zhongyi33/2021-Fall-ECE-411-Team-10/Photos/2.jpg

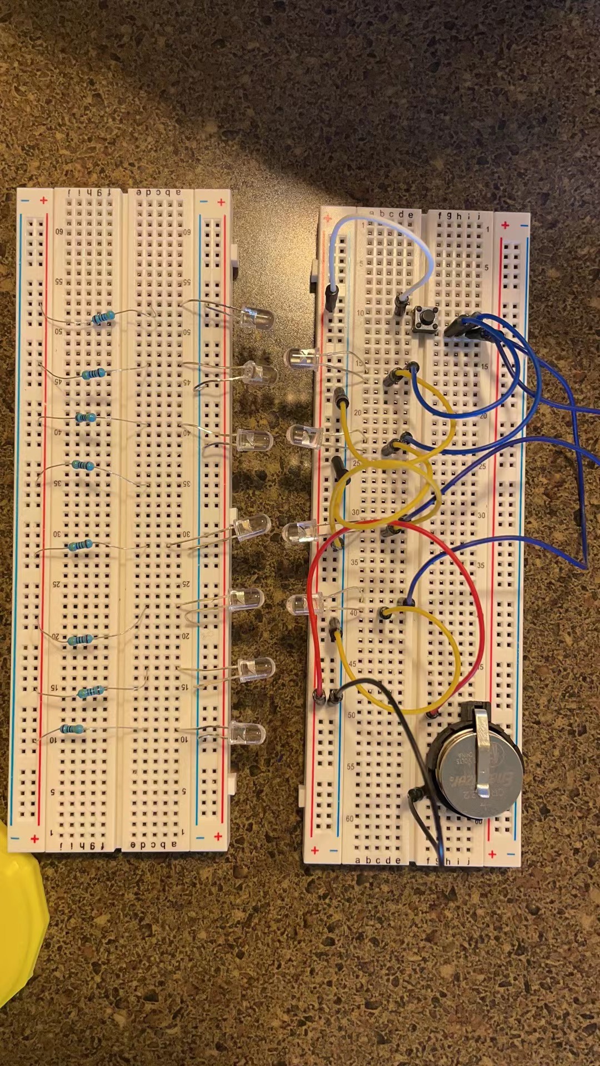
Photos/2.jpg
