zhongyi33/2021-Fall-ECE-411-Team-10/Photos/1.jpg

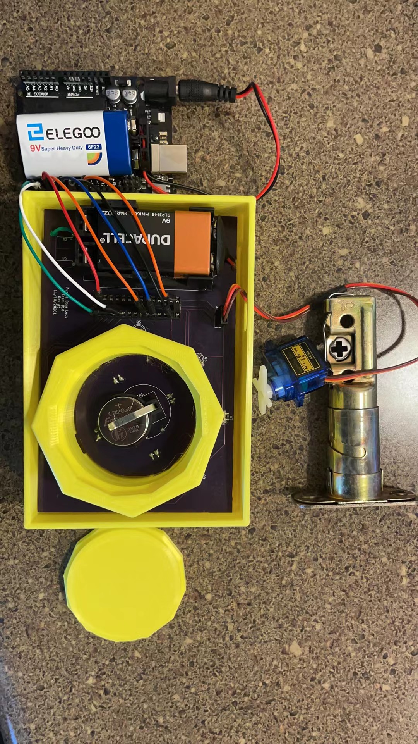
Photos/1.jpg
