zhongyi33/2021-Fall-ECE-411-Team-10/README.md

# 2021-Fall-ECE-411-Team-10

Group member: Bradley Huntington, Lihong Zhao, Tianshu Chu, Zhongyi Xu
