zhongyi33/2021-Fall-ECE-411-Team-10/ECE411 Team10 Final  Version of Project Schedule.pdf

2021 Fall ECE411 Team10 Puzzle lock | Nov 4, 2021
ECE411 team10 | http://
Project manager | Zhongyi Xu, Tianshu Chu, Lihong Zhao, Bradley Huntington
Project dates | Oct 7, 2021 - Dec 1, 2021
Completion | 44%
Tasks | 28
Resources | 4

Name | Begin date | End date | Coordinator
Develop Product Design Specifications | 10/7/21 | 10/20/21 | Bradley Huntington, Lihong Zhao, Tianshu Chu, Zhongyi Xu
Doucmentation: Brief Market analysis | 10/12/21 | 10/14/21 | Zhongyi Xu
System Architecture | 10/12/21 | 10/20/21 | Lihong Zhao
Choose Sensor/Controller/Firmware | 10/12/21 | 10/20/21 | Bradley Huntington
Choosing IDE | 10/12/21 | 10/20/21 | Tianshu Chu
Determining Appearance/Material /Shape of the lock | 10/12/21 | 10/15/21 | Lihong Zhao, Bradley Huntington
Start Github/Trello Organization | 10/7/21 | 10/13/21 | Zhongyi Xu, Tianshu Chu, Lihong Zhao
Schematic | 10/21/21 | 11/12/21 | Bradley Huntington
Preliminary Schematic Designing | 10/21/21 | 10/28/21 | Bradley Huntington
Update Schematic | 10/28/21 | 11/4/21 | Bradley Huntington
Final Schematic | 11/4/21 | 11/12/21 | Bradley Huntington
PCB | 10/28/21 | 11/19/21 | Bradley Huntington
First Draft | 10/28/21 | 11/4/21 | Bradley Huntington
Modifying Draft | 11/4/21 | 11/12/21 | Bradley Huntington
Generating Final Draft | 11/12/21 | 11/19/21 | Bradley Huntington
Block diagram | 10/21/21 | 11/26/21 | Lihong Zhao
Level 1 Block Diagram | 10/21/21 | 10/28/21 | Lihong Zhao
Level 0 Block Diagram | 11/4/21 | 11/15/21 | Lihong Zhao
Final Checking to Level 0&1 Block Diagram | 11/18/21 | 11/26/21 | Lihong Zhao
Bill of Materials | 11/4/21 | 11/26/21 | Zhongyi Xu
First Version | 11/4/21 | 11/12/21 | Zhongyi Xu
Final Version | 11/18/21 | 11/26/21 | Zhongyi Xu
2021 Fall ECE411 Team10 Puzzle lock | Nov 4, 2021
Tasks | 2

Name | Begin date | End date | Coordinator
3D Module | 11/12/21 | 11/26/21 | Tianshu Chu, Lihong Zhao, Bradley Huntington
Designing | 11/12/21 | 11/18/21 | Tianshu Chu
Printing 3D Module | 11/18/21 | 11/26/21 | Lihong Zhao, Bradley Huntington
Final Assembiy/Testing | 11/22/21 | 11/30/21 | Zhongyi Xu, Tianshu Chu, Lihong Zhao, Bradley Huntington
Testing | 11/22/21 | 11/22/21 | Lihong Zhao, Bradley Huntington
Debug | 11/22/21 | 11/30/21 | Tianshu Chu, Lihong Zhao
Tasks | 3

Name | Default role
Zhongyi Xu | project manager
Tianshu Chu | project manager
Lihong Zhao | project manager
Bradley Huntington | project manager

## Resources

4

## Gantt Chart

5

Name | Begin da... | End date | Coordinator
Develop Product ... 10/7/21 | 10/20/21 Bradley Huntingto...

Doucmentatio... 10/12/... 10/14/21 Zhongyi Xu

System Archit... 10/12/... 10/20/21 Lihong Zhao

Choose Senso... 10/12/... 10/20/21 Bradley Huntington

Choosing IDE 10/12/... 10/20/21 Tianshu Chu

Determining A... 10/12/... 10/15/21 Lihong Zhao, Bradl...

Start Github/T... 10/7/21 | 10/13/21 Zhongyi Xu, Tiansh...
Schematic | 10/21/... 11/12/21 Bradley Huntington

Preliminary Sc... 10/21/... 10/28/21 Bradley Huntington

Update Sche... 10/28/... 11/4/21 | Bradley Huntington
Final Schematic 11/4/21 | 11/12/21 Bradley Huntington
PCB | 10/28/... 11/19/21 Bradley Huntington
First Draft | 10/28/... 11/4/21 | Bradley Huntington
Modifying Draft 11/4/21 | 11/12/21 Bradley Huntington

Generating Fi... 11/12/... 11/19/21 Bradley Huntington

Block diagram 10/21/... 11/26/21 Lihong Zhao

Level 1 Block ... 10/21/... 10/28/21 Lihong Zhao

Level 0 Block ... 11/4/21 11/15/21 Lihong Zhao

Final Checking... 11/18/... 11/26/21 Lihong Zhao

Bill of Materials | 11/4/21 | 11/26/21 Zhongyi Xu
First Version | 11/4/21 | 11/12/21 Zhongyi Xu
Final Version | 11/18/... 11/26/21 Zhongyi Xu
3D Module | 11/12/... 11/26/21 Tianshu Chu, Lihon...
Designing | 11/12/... 11/18/21 Tianshu Chu

Printing 3D M... 11/18/... 11/26/21 Lihong Zhao, Bradl...

Final Assembiy/T... 11/22/... 11/30/21 Zhongyi Xu, Tiansh...

Testing | 11/22/... 11/22/21 Lihong Zhao, Bradl...
Debug | 11/22/... 11/30/21 Tianshu Chu, Lihon...
November 2021 | December 2021
Week 41 | Week 42 | Week 43 | Week 44 | Week 45 | Week 46 | Week 47 | Week 48 | Week 49 | Week 50
10/3/21 | 10/10/21 | 10/17/21 | 10/24/21 | 10/31/21 | 11/7/21 | 11/14/21 | 11/21/21 | 11/28/21 | 12/5/21

## Resources Chart

6

Bradley Huntington | project ma...
300% | 200% | 200% | 200% | 400% | 400% | 300% | 400% | 300%
