zhongyi33/2021-Fall-ECE-411-Team-10/Block Diagram/Puzzle Lock Level 0.pdf

Puzzle Lock: Level 0

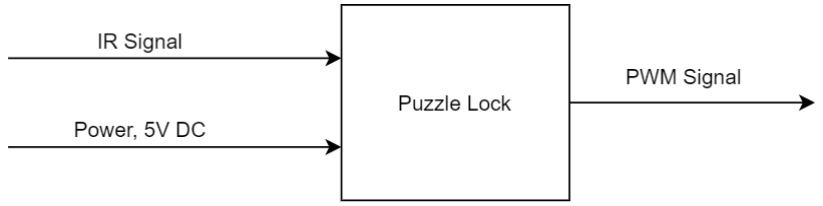
[picture p7: figure]

Module | Puzzle Lock
Inputs | IR Signal: From the IR transmitter on the Key Power: 5V DC
Outputs | PWM: Generated from the controller to control the servo
Functionality | After the IR signal is correctly received and the key is in the right position, the Puzzle Lock will send a PWM signal to the servo to control the lock.
