zhongyi33/2021-Fall-ECE-411-Team-10/Photos/gantt chart 2.png

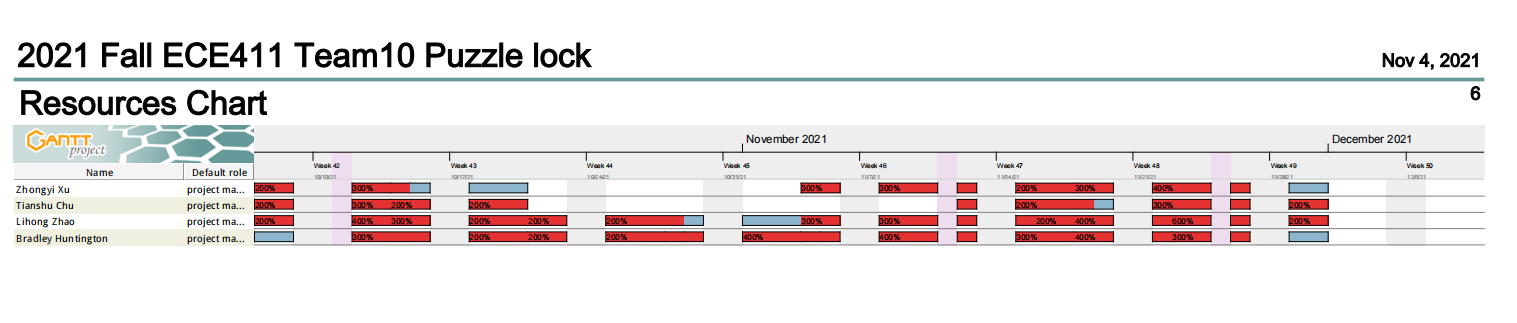
Photos/gantt chart 2.png
