zhongyi33/2021-Fall-ECE-411-Team-10/Photos/gantt project.png

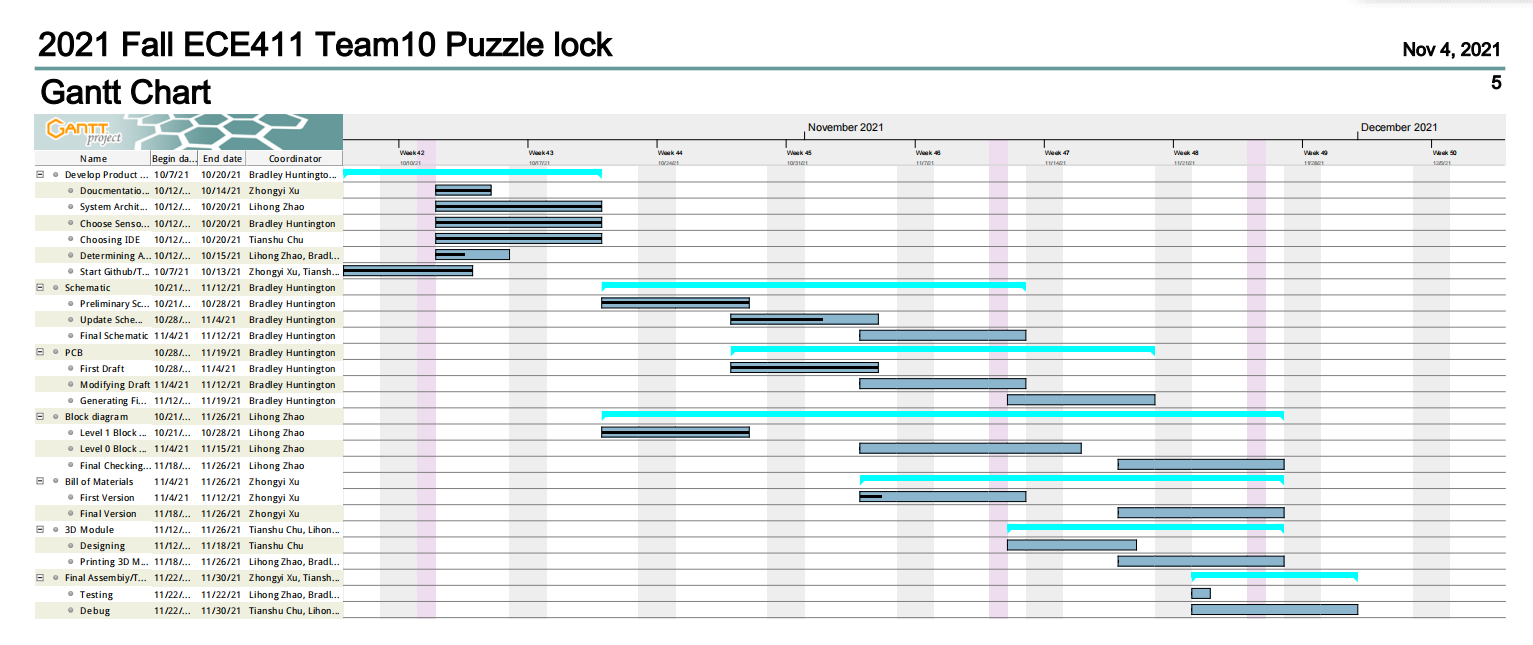
Photos/gantt project.png
