zhongyi33/2021-Fall-ECE-411-Team-10/Photos/level1 .png

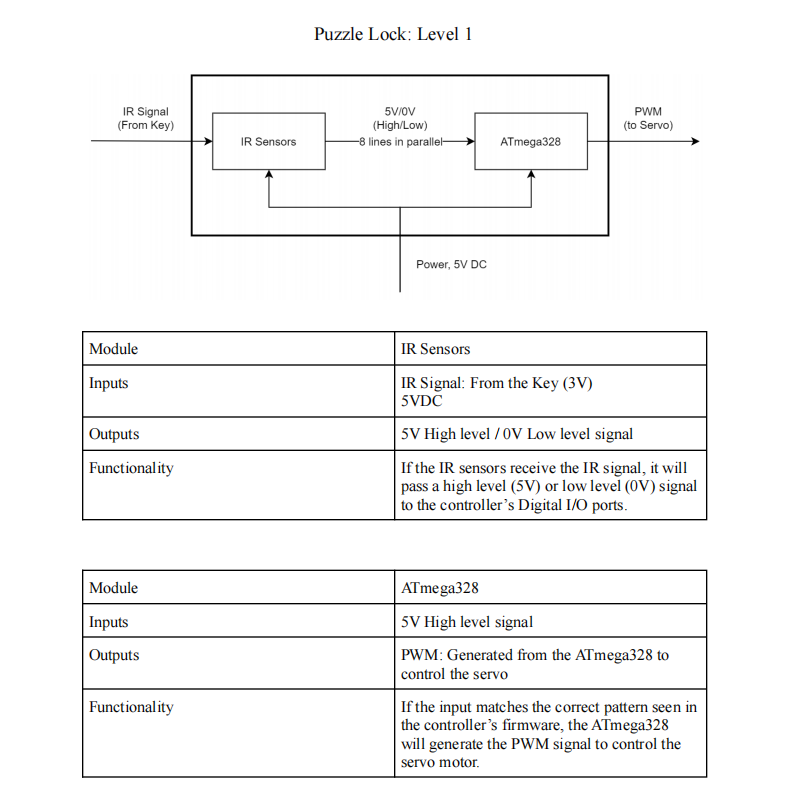
Photos/level1 .png
