zhongyi33/2021-Fall-ECE-411-Team-10/Photos/level 1 key.png

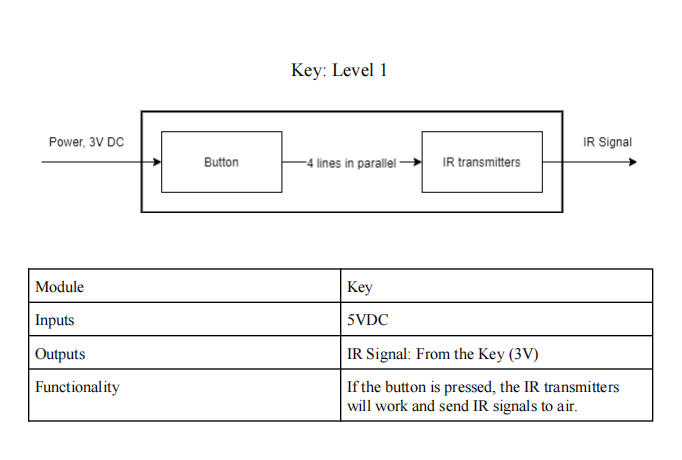
Photos/level 1 key.png
