zhongyi33/2021-Fall-ECE-411-Team-10/ECE411 Team10 BOM.xlsx

Bill Of Materials for: Team 10 Puzzle Lock
Last modified: 11/9/2021
PCB version: [3]
BOM revision: [3] |  | P/NP | Place/Not Place (components marked NP are not stuffed on the board)
Cnt | Part References | P/NP | Mfg | Mfg PN | Description | Dist | Dist Part Number | Cost Ea. | Cost Total
1 | M1 | P | Smraza |  | Micro Servo 9g Motor SG90 | Amazon | B07L2SF3R4 | $2.20 | $2.20
4 | D1, D2, D3, D4 | P | Uxcell |  | 940nm Infrared Emitter Diode DC 1.2V LED IR Emitter Light Emitting Diodes Clear Round Head 7 Meters Emission Distance | Amazon | B07VH7PMB3 | $0.40 | $1.60
1 | BT1 | P | LAMPVPATH |  | CR2032 2025 2015 Battery Holder, Coin Cell Button Socket Holder Case, CR2032 2025 2015 Coin Cell Button Battery Holder with 2 Pin Solder Mounting Lead | Amazon | B08SQJJJNK | $0.50 | $0.50
1 | SW1 | P | ‎DIYhz | 10006 | DIYhz Momentary Push Button Switch, 1A 250VAC SPST Mini Pushbutton Switches Normally Open(NO) Black Cap | Amazon | B07BD1MS18 | $0.45 | $0.45
1 | R1, R2 | P | E-Projects | 100EP5121K00 | 1k Ohm Resistors, 1/2 W, 5% | Amazon | B0185FIJ9A | $0.07 | $0.07
8 | Q1, Q2, Q3, Q4, Q5, Q6, Q7, Q8 | P | HiLetgo | ‎3-01-0591 | 5MM Photodiode Photosensitive Diode Light Sensitive Diode Round F5 Photodiode 3V | Amazon | B00M1PMHO4 | $0.25 | $2.00
1 | D5 | P | AnaTek Instruments |  | 1N4733 1N4733A ZENER DIODE 1W 5.1V | Amazon | B00I6ID654 | $0.50 | $0.50
1 | BT2 | P | MPD (Memory Protection Devices) | BC9VPC | BATT HOLDER 9V 1 CELL PC PIN | Digi Key | BC9VPC-ND | $2.19 | $2.19
4 | U1 | P | Vetco |  | 28 Pin DIP IC Socket Works Great For Arduino Uno Chip (D86) | Vetco | VUPN7337 | $0.95 | $3.80
1 | ATmega328 | NP | Flashtree |  | Flashtree Atmega328P-PU Atmega328p Microcontroller with Uno R3 Bootloader DIP28 | Amazon | B07JJX961X | $3.50 | $3.50
1 | Door lock | NP | Amazon Basics | ‎LT10610 | Deadbolt - Single Cylinder - Antique Brass | Amazon | B07J5HR777 | $10.99 | $10.99
 |  |  |  |  |  |  |  | TOTAL: | $27.80
