zhongyi33/2021-Fall-ECE-411-Team-10/3D Model/Key'' - Part 2.stl

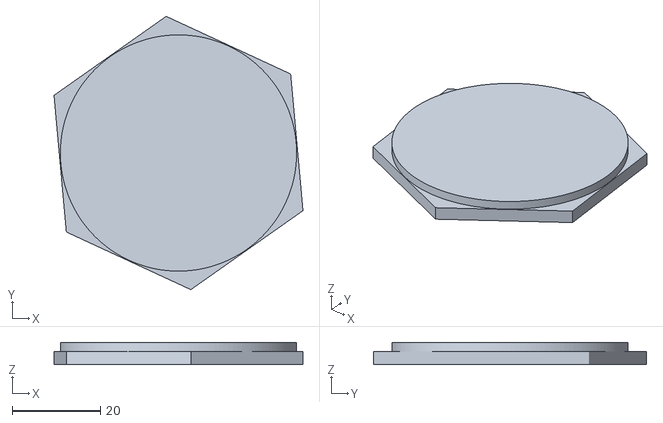
[picture p12: CAD file, 2021-12-02]
3D Model/Key'' - Part 2.stl
56.4 x 61.9 x 5.00
