zhongyi33/2021-Fall-ECE-411-Team-10/3D Model/Key'' - Part 1.stl

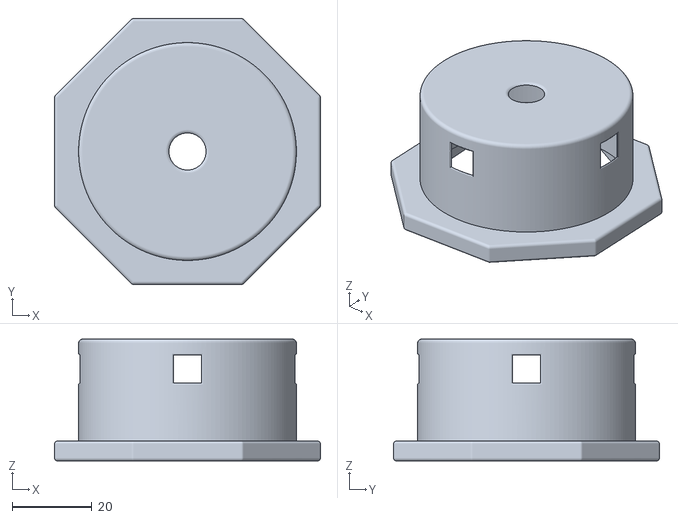
[picture p13: CAD file, 2021-12-02]
3D Model/Key'' - Part 1.stl
66.6 x 66.6 x 30.5
