zhongyi33/2021-Fall-ECE-411-Team-10/3D Model/Mount'' - Part 2.stl

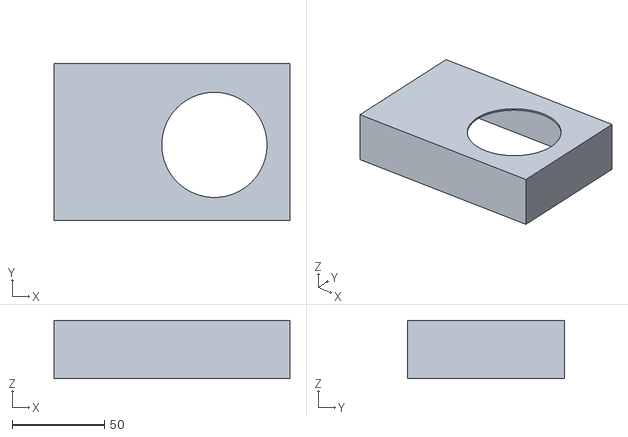
[picture p14: CAD file, 2021-12-02]
3D Model/Mount'' - Part 2.stl
128.0 x 85.0 x 31.5
