zhongyi33/2021-Fall-ECE-411-Team-10/3D Model/Mount'' - Part 1.stl

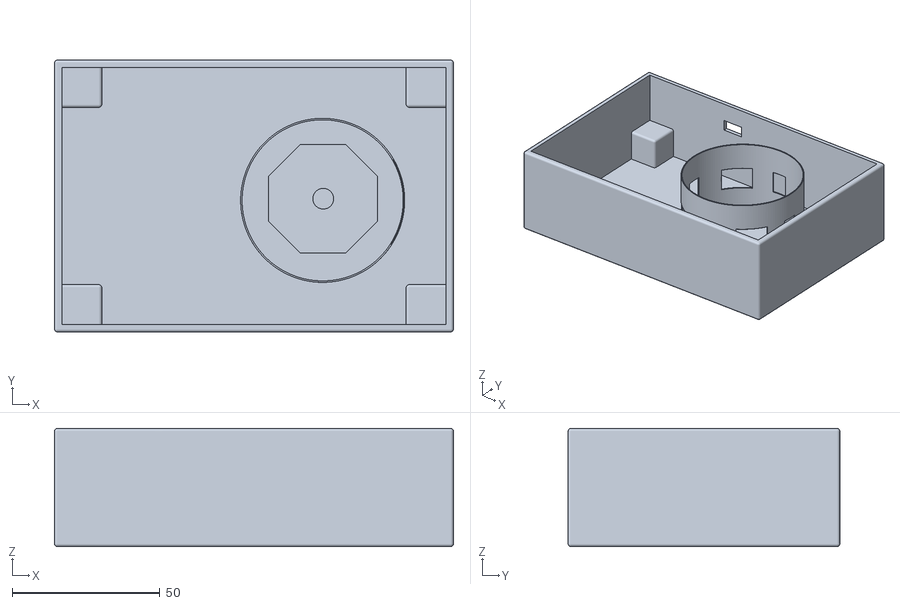
[picture p15: CAD file, 2021-12-02]
3D Model/Mount'' - Part 1.stl
135.0 x 92.0 x 40.0
