zhongyi33/2021-Fall-ECE-411-Team-10/CAD/CAD final/Puzzle_Lock (2).kicad_pcb

## KiCad design CAD/CAD final/Puzzle_Lock (2).kicad_pcb (2021-12-09)

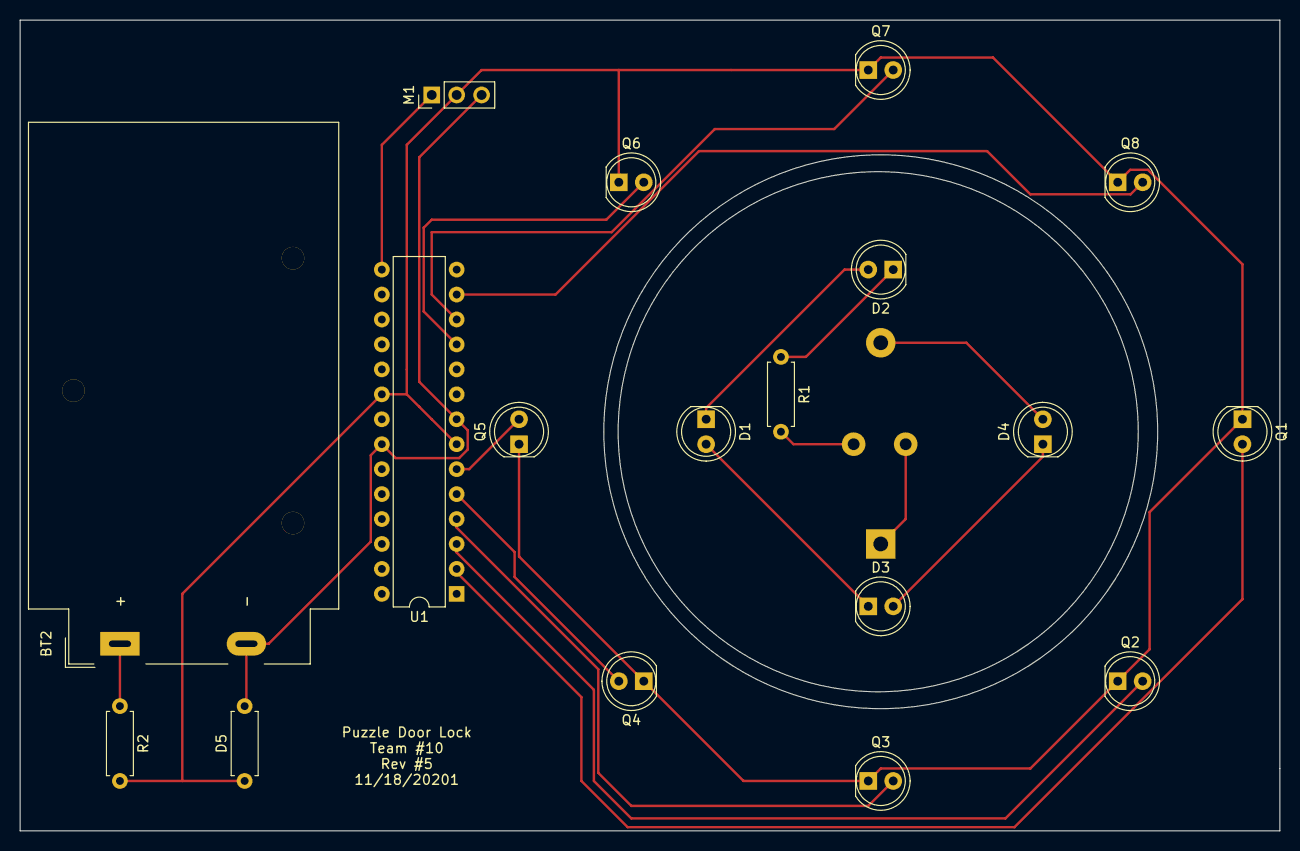
[picture p16: board Puzzle_Lock (2).kicad_pcb from above]

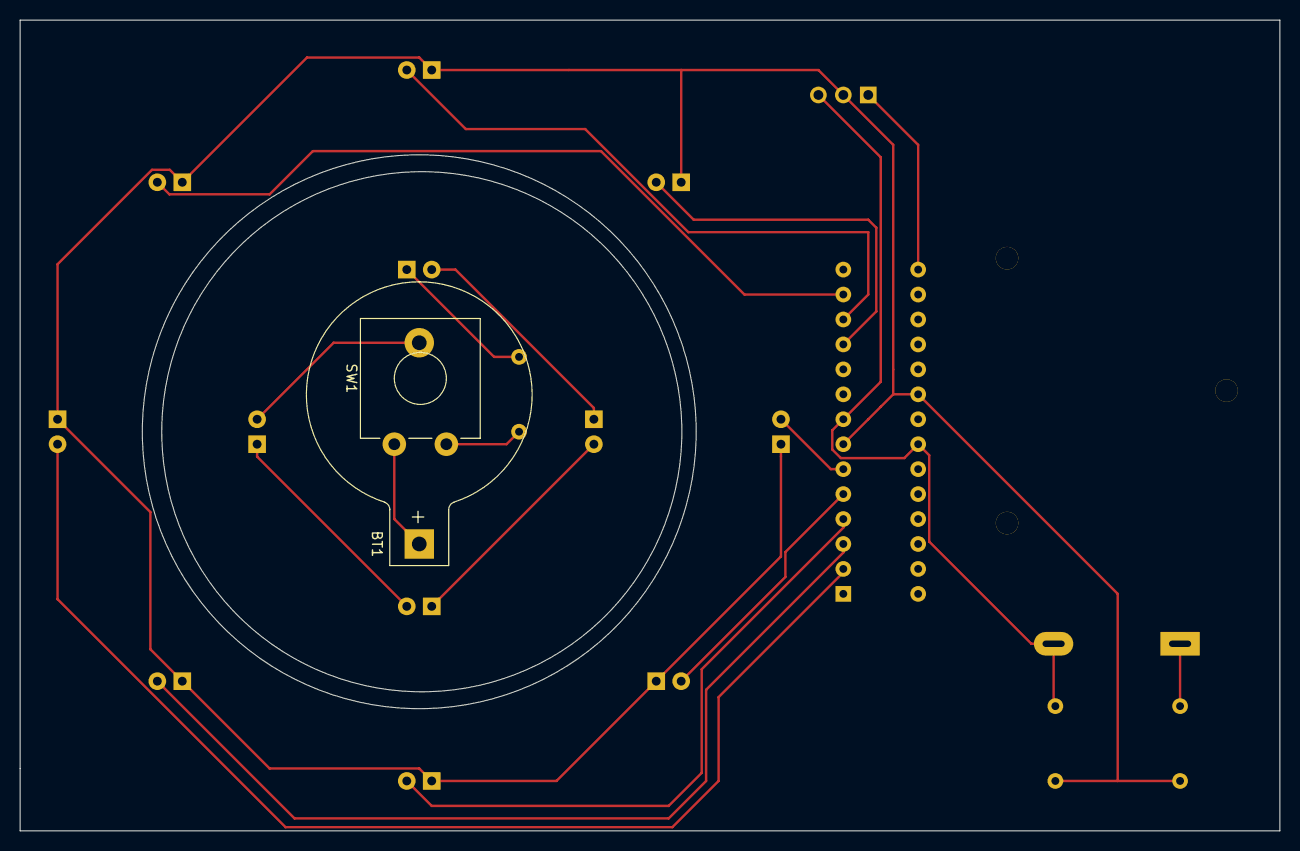
[picture p17: board Puzzle_Lock (2).kicad_pcb from below]

Board: 2 copper layers, 128.3 x 82.5 mm, 20 parts (2 on the bottom side), 19 nets.

Parts:
BT1: 3V; BatteryHolder_Keystone_103_1x20mm
BT2: 9; BatteryHolder_MPD_BA9VPC_1xPP3
D1, D2, D3, D4: LED; LED_D5.0mm
D5: 5.1V; R_Axial_DIN0207_L6.3mm_D2.5mm_P7.62mm_Horizontal
M1: Motor_Servo; PinHeader_1x03_P2.54mm_Vertical
Q1, Q2, Q3, Q4, Q5, Q6, Q7, Q8: Q_Photo_NPN; LED_D5.0mm
R1: 100; R_Axial_DIN0207_L6.3mm_D2.5mm_P7.62mm_Horizontal
R2: 1K; R_Axial_DIN0207_L6.3mm_D2.5mm_P7.62mm_Horizontal
SW1: _; SW_CW_GPTS203211B
U1: ATmega8L-8PU; DIP-28_W7.62mm

Connections:
unnamed: BT1.1, SW1.1
unnamed: BT1.2, D4.2
unnamed: BT2.1, R2.1
unnamed: BT2.2, D5.2, M1.3, U1.8, U1.22
unnamed: D1.1, D2.2
unnamed: D1.2, D3.1
unnamed: D2.1, R1.1
unnamed: D3.2, D4.1
unnamed: D5.1, M1.2, Q1.1, Q2.1, Q3.1, Q4.1, Q5.1, Q6.1, Q7.1, Q8.1, R2.2, U1.7, U1.20
unnamed: M1.1, U1.15
unnamed: Q1.2, U1.2
unnamed: Q2.2, U1.3
unnamed: Q3.2, U1.4
unnamed: Q4.2, U1.5
unnamed: Q5.2, U1.6
unnamed: Q6.2, U1.11
unnamed: Q7.2, U1.12
unnamed: Q8.2, U1.13
unnamed: R1.2, SW1.2
