zhongyi33/2021-Fall-ECE-411-Team-10/(commit log)

2021-10-29 add the Breadboard Prototype at 10/28/2021
2021-11-10 week7: rough draft of CAD
    [Puzzle_Lock.kicad_pcb, Puzzle_Lock.sch]
2021-11-15 Create CAD
2021-11-15 week 7 : rough draft of CAD
    [Puzzle_Lock.kicad_pcb, Puzzle_Lock.sch]
2021-12-08 added the function to display the current signal
2021-12-09 Add BOM
    [ECE411 Team10 BOM.xlsx]
2021-12-09 Add PCB finals
    [Puzzle_Lock (1).sch, Puzzle_Lock (2).kicad_pcb]
2021-12-09 add board and key pictures
